sztsian/crazyradio-electronics/ecad/Crazyradio.kicad_pcb

## KiCad design ecad/Crazyradio.kicad_pcb (2020-12-18)

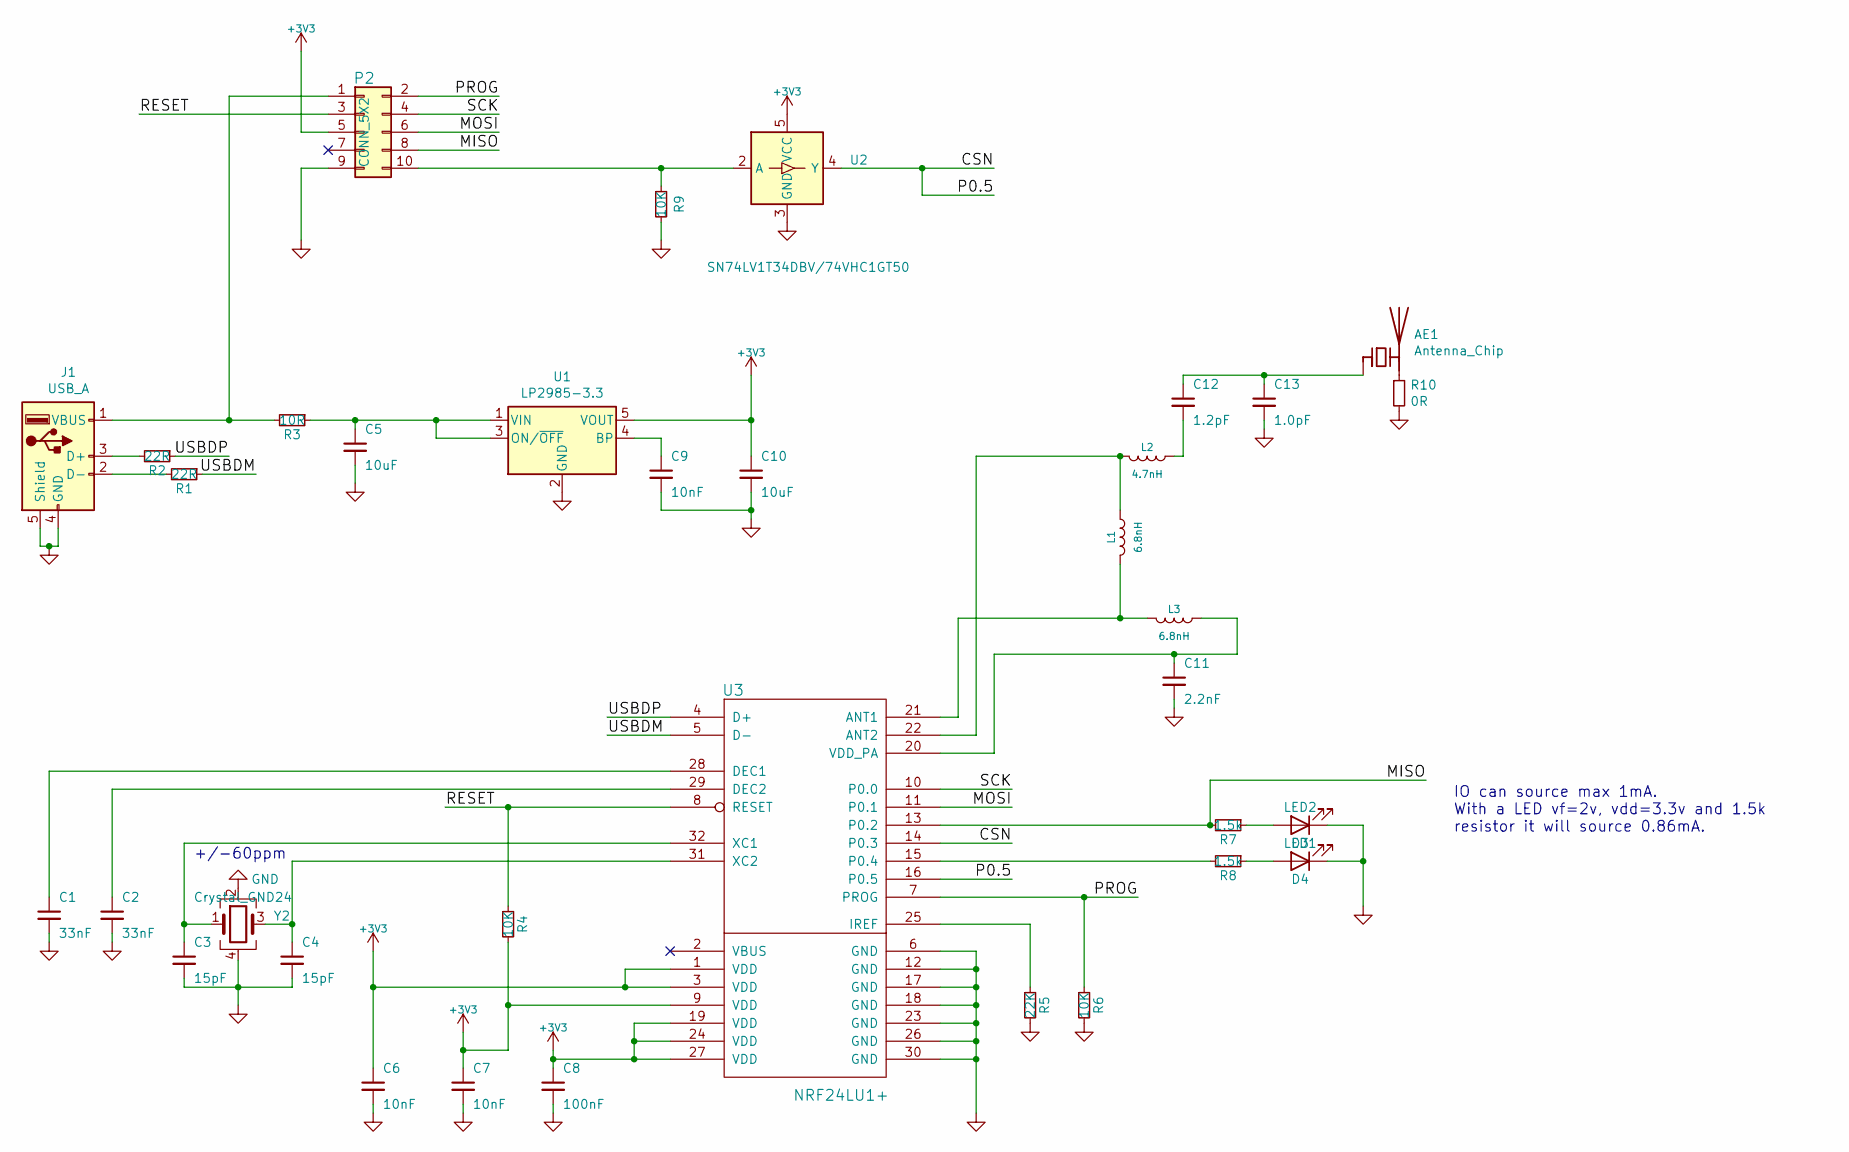
[picture p1: schematic Crazyradio.sch]

Parts:
AE1: Antenna_Chip; Texas_SWRA117D_2.4GHz_Right
C1, C2: 33nF; C_0603_1608Metric_Pad1.08x0.95mm_HandSolder
C3, C4: 15pF; C_0603_1608Metric_Pad1.08x0.95mm_HandSolder
C5, C10: 10uF; C_0603_1608Metric_Pad1.08x0.95mm_HandSolder
C6, C7, C9: 10nF; C_0603_1608Metric_Pad1.08x0.95mm_HandSolder
C8: 100nF; C_0603_1608Metric_Pad1.08x0.95mm_HandSolder
C11: 2.2nF; C_0603_1608Metric_Pad1.08x0.95mm_HandSolder
C12: 1.2pF; C_0603_1608Metric_Pad1.08x0.95mm_HandSolder
C13: 1.0pF; C_0603_1608Metric_Pad1.08x0.95mm_HandSolder
D3: LED2; LED_0603_1608Metric_Pad1.05x0.95mm_HandSolder
D4: LED1; LED_0603_1608Metric_Pad1.05x0.95mm_HandSolder
J1: USB_A
L1, L3: 6.8nH; L_0603_1608Metric_Pad1.05x0.95mm_HandSolder
L2: 4.7nH; L_0603_1608Metric_Pad1.05x0.95mm_HandSolder
P2: CONN_5X2; PinHeader_2x05_P2.54mm_Vertical
R1, R2: 22R; R_0603_1608Metric_Pad0.98x0.95mm_HandSolder
R3: 10R; R_0603_1608Metric_Pad0.98x0.95mm_HandSolder
R4, R6, R9: 10K; R_0603_1608Metric_Pad0.98x0.95mm_HandSolder
R5: 22K; R_0603_1608Metric_Pad0.98x0.95mm_HandSolder
R7, R8: 1.5k; R_0603_1608Metric_Pad0.98x0.95mm_HandSolder
R10: 0R; R_0603_1608Metric_Pad0.98x0.95mm_HandSolder
U1: LP2985-3.3; SOT-23-5
U2: SN74LV1T34DBV/74VHC1GT50; SOT-23-5
U3: NRF24LU1+; QFN-32-1EP_5x5mm_P0.5mm_EP3.3x3.3mm
Y2: Crystal_GND24; Crystal_SMD_2520-4Pin_2.5x2.0mm

Connections:
+3V3: C6.1, C7.1, C8.1, C10.1, P2.5, R4.2, U1.5 (VOUT), U2.5 (VCC), U3.1 (VDD), U3.3 (VDD), U3.9 (VDD), U3.19 (VDD), U3.24 (VDD), U3.27 (VDD)
/CSN: U2.4 (Y), U3.14 (P0.3), U3.16 (P0.5)
/MISO: P2.8, R7.2, U3.13 (P0.2)
/MOSI: P2.6, U3.11 (P0.1)
/PROG: P2.2, R6.1, U3.7 (PROG)
/RESET: P2.3, R4.1, U3.8 (RESET)
/SCK: P2.4, U3.10 (P0.0)
/USBDM: R1.1, U3.5 (D-)
/USBDP: R2.1, U3.4 (D+)
GND: C1.2, C2.2, C3.2, C4.2, C5.2, C6.2, C7.2, C8.2, C9.2, C10.2, C11.2, C13.2, D3.1 (K), D4.1 (K), J1.4 (GND), J1.5 (Shield), P2.9, R5.2, R6.2, R9.2, R10.2, U1.2 (GND), U2.3 (GND), U3.6 (GND), U3.12 (GND), U3.17 (GND), U3.18 (GND), U3.23 (GND), U3.26 (GND), U3.30 (GND), Y2.2, Y2.4
unnamed: AE1.1 (FEED), C12.1, C13.1
unnamed: AE1.2 (PCB_Trace), R10.1
unnamed: C1.1, U3.28 (DEC1)
unnamed: C2.1, U3.29 (DEC2)
unnamed: C3.1, U3.32 (XC1), Y2.1
unnamed: C4.1, U3.31 (XC2), Y2.3
unnamed: C5.1, R3.1, U1.1 (VIN), U1.3 (ON/~OFF~)
unnamed: C9.1, U1.4 (BP)
unnamed: C11.1, L3.1, U3.20 (VDD_PA)
unnamed: C12.2, L2.1
unnamed: D3.2 (A), R7.1
unnamed: D4.2 (A), R8.1
unnamed: J1.1 (VBUS), P2.1, R3.2
unnamed: J1.2 (D-), R1.2
unnamed: J1.3 (D+), R2.2
unnamed: L1.1, L2.2, U3.22 (ANT2)
unnamed: L1.2, L3.2, U3.21 (ANT1)
unnamed: P2.10, R9.1, U2.2 (A)
unnamed: R5.1, U3.25 (IREF)
unnamed: R8.2, U3.15 (P0.4)

Notes on the sheet:
IO can source max 1mA. With a LED vf=2v, vdd=3.3v and 1.5k resistor it will source 0.86mA.
+/-60ppm

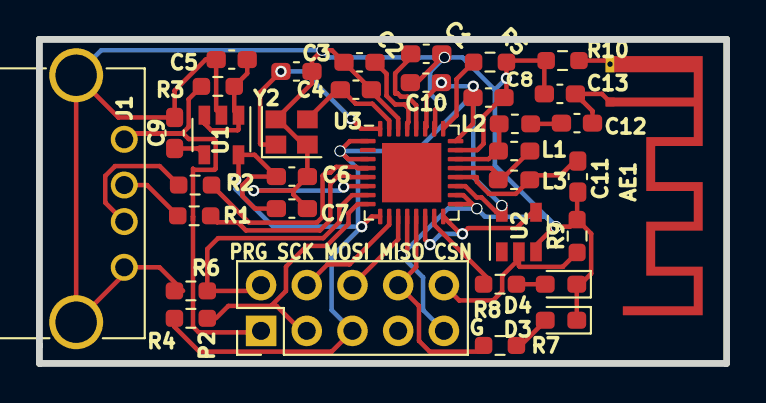
[picture p2: board Crazyradio.kicad_pcb from above]

Board: 2 copper layers, 38.2 x 18.0 mm, 35 parts (0 on the bottom side), 30 nets.
