sztsian/crazyradio-electronics/(notices)

Notices in the files:
ecad/Crazyradio.sch:
Bitcraze AB (CC BY-NC-SA)
